Meghd2cx/EECS149-AdjustableCamber/README.md

# EECS149-AdjustableCamber
EECS149 Spring 149 Project
