Meghd2cx/EECS149-AdjustableCamber/State Machine.pdf

STRAIGHT

ENTRY /
EXIT

APEX

### Inputs: Enable : pure, StrPos ∈ ℝ Outputs: CamberDes ∈ ℝ Constants: StrOffset, StrError, StrSteady ∈ ℝ

## Notes:

- Enable → button input to enable active camber control - StrPos → Steering Linear Potentiometer Voltage [V] - CamberDes → desired camber angle - StrOffset → voltage at neutral/center steering position - StrError → max voltage error for neutral/center steering position - StrSteady → max allowed change in steering for constant steering

### Left Front Corner - Steering left → positive steering lin pot voltage, inside tire - Steering right → negative steering lin pot voltage, outside tire

| StrPos - StrOffset| > StrError && StrPos > StrOffset / CamberDes:= 1º
| StrPos - StrOffset| > StrError && StrPos < StrOffset / CamberDes = -1º

| StrPos - StrOffset| < StrError / CamberDes:= -0.5º

|d/dt (StrPos) | < StrSteady && StrPos > StrOffset /
CamberDes:= 2º
|d/dt (StrPos) | < StrSteady && StrPos < StrOffset /
CamberDes = -2º

sign(d/dt(StrPos)) ≠ sign(StrPos - StrOffset) && StrPos > StrOffset / CamberDes:= 1º
sign(d/dt(StrPos)) ≠ sign(StrPos - StrOffset) && StrPos < StrOffset /
CamberDes = -1º
Enable / | OFF
CamberDes := -0.5º | not(Enable) / CamberDes := -0.5º

not(Enable) /
CamberDes := -0.5º | not(Enable) /
| CamberDes := -0.5º

not(Enable) /
CamberDes := -0.5º
