Meghd2cx/EECS149-AdjustableCamber/BOM.xlsx

Subsystem | Required Parts | Listing Name | Quantity | Cost | Source Links
Mechanical | 3D-Printing Filament for Upright | Markforged Onyx Filament | 211 cc | - | personal printer material
 | Tubes for Upper Control-Arms | Easy-to-Weld 4130 Alloy Steel Round Tube, 0.035" Wall Thickness, 1/2" OD | 3 ft | - | borrowed from Berkeley Formula Racing
 | Tubes for Lower Control-Arms | Easy-to-Weld 4130 Alloy Steel Round Tubes | 6 ft | - | borrowed from Berkeley Formula Racing
 | Tubes for Camber Movement Arm | Easy-to-Weld 4130 Alloy Steel Round Tube, 0.035" Wall Thickness, 1/2" OD | 1 ft | - | borrowed from Berkeley Formula Racing
 | Tubes for Steering Tierod | Easy-to-Weld 4130 Alloy Steel Round Tube, 0.035" Wall Thickness, 1/2" OD | 1 ft | - | borrowed from Berkeley Formula Racing
 | Tube for Pushrod |  | 1 ft | - | borrowed from Berkeley Formula Racing
 | Welding Filler | Steel Welding Filler | ~2 rods | - | borrowed from Berkeley Formula Racing
 | Spring & Shock |  | 1 | - | borrowed from Berkeley Formula Racing
 | Upper Outer Ball Joint |  | 1 | - | borrowed from Berkeley Formula Racing
 | Upper Inner Ball Joint |  | 1 | - | borrowed from Berkeley Formula Racing
 | Lower Outer Ball Joint |  | 1 | - | borrowed from Berkeley Formula Racing
 | Lower Inner Ball Joint |  | 2 | - | borrowed from Berkeley Formula Racing
 | Steering Outer Ball Joint |  | 1 | - | borrowed from Berkeley Formula Racing
 | Motor Linkage stock |  | 1 | - | borrowed from Berkeley Formula Racing
 | Pushbar Linkage Stock |  | 1 | - | borrowed from Berkeley Formula Racing
 | AN3 Bolts |  | 14 | - | borrowed from Berkeley Formula Racing
 | AN3 washers |  | 28 | - | borrowed from Berkeley Formula Racing
 | AN3 KNuts |  | 4 | - | borrowed from Berkeley Formula Racing
 | Rod Ends |  | 8 | - | borrowed from Berkeley Formula Racing
Electrical | Microcontroller | ESP32-WROOM32UE | 1 | $16.99 | Amazon.com: ESP-WROOM-32 ESP32 ESP-32S Development Board 2.4GHz Dual-Mode WiFi + Bluetooth Dual Cores Microcontroller Processor Integrated with Antenna RF AMP Filter AP STA Compatible with Arduino IDE (3PCS) : Electronics (https://www.amazon.com/ESP-WROOM-32-Development-Microcontroller-Integrated-Compatible/dp/B08D5ZD528)
 | CAN Controller | Comimark 5Pcs CAN Bus Module Transceiver TJA1050 Controller Board | 1 | $8.99 | Amazon.com: Comimark 5Pcs CAN Bus Module Transceiver TJA1050 Controller Schnittstelle Board for Arduino : Electronics (https://www.amazon.com/Comimark-Transceiver-TJA1050-Controller-Schnittstelle/dp/B07W4VZ2F2)
 | Motor | 131:1 Metal Gearmotor 37Dx73L mm 12V with 64 CPR Encoder (Helical Pinion) | 1 | $51.95 | https://www.pololu.com/product/4756
 | Motor Driver | Pololu Dual VNH5019 Motor Driver Shield for Arduino | 1 | $59.95 | https://www.pololu.com/product/2507
 | 12v Vehicle Battery | Shorai LFX19A4-BS12 | 1 | - | borrowed from Berkeley Formula Racing
 | Steering Angle Potentiometer | Corsa Technic SEN-LHP | 1 | - | borrowed from Berkeley Formula Racing
 | Inertial Measurement Unit | Izze-Racing 6-DOF CAN Inertial Measurement Unit | 1 | - | borrowed from Berkeley Formula Racing
 | Total |  |  | $137.88
