Meghd2cx/EECS149-AdjustableCamber/CAD/24-SU-14-000.SLDASM

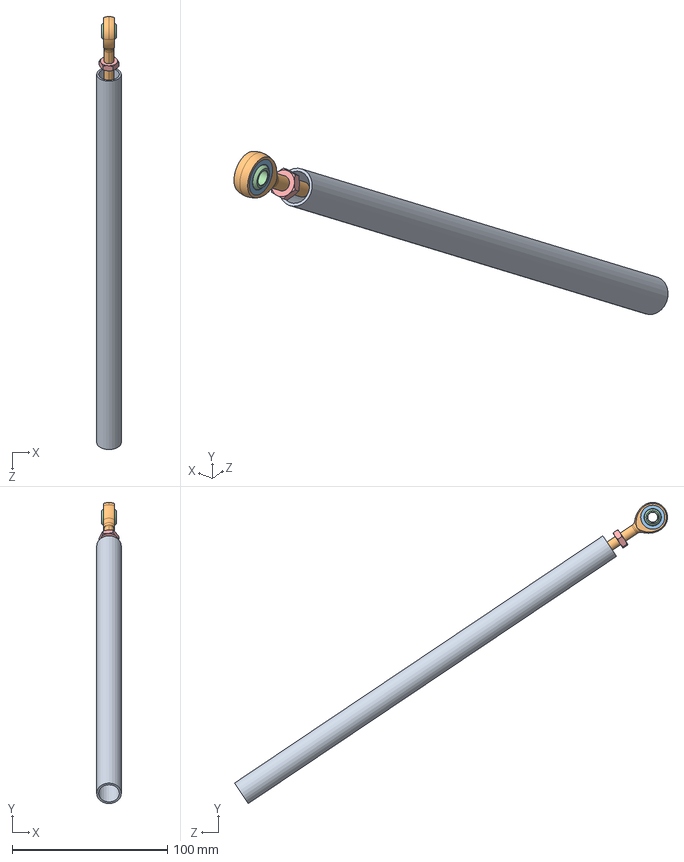
[picture p7: CAD file, 2024-11-09]
CAD/24-SU-14-000.SLDASM
15.9 x 193.9 x 278.8 mm
24-SU-14-001
MM-4T Rod End Body
MM-4T Bearing Bore
MM-4T Ball Bearing
AN4_JamNut
