Meghd2cx/EECS149-AdjustableCamber/CAD/MM-4T.SLDASM

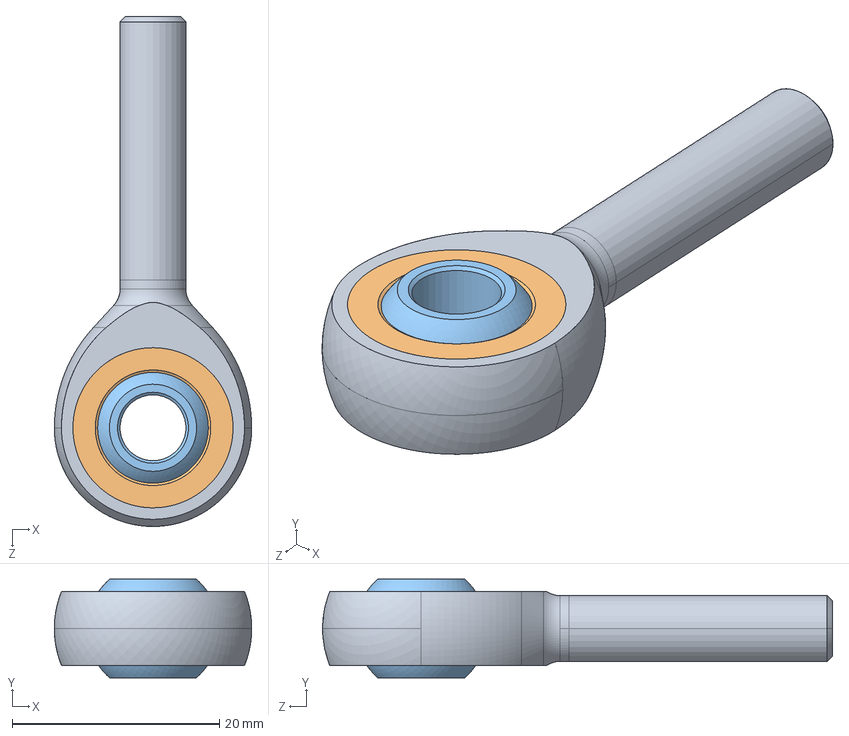
[picture p8: CAD file, 2024-11-09]
CAD/MM-4T.SLDASM
19.1 x 9.53 x 49.2 mm
MM-4T Rod End Body
MM-4T Bearing Bore
MM-4T Ball Bearing
