Meghd2cx/EECS149-AdjustableCamber/CAD/23-SU-15-000.SLDASM

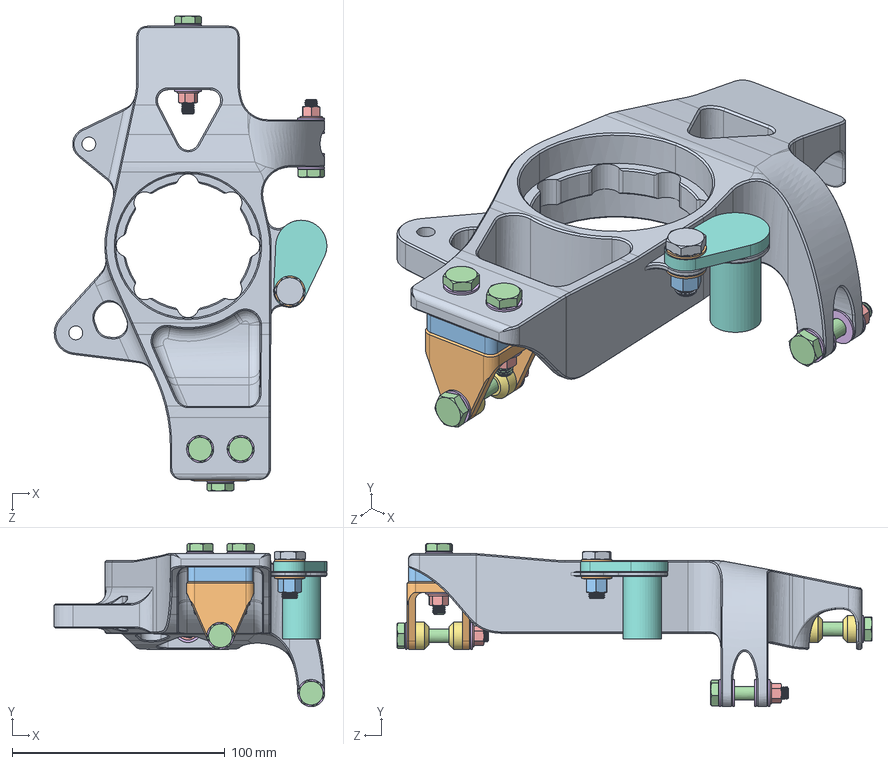
[picture p9: CAD file, 2024-11-09]
CAD/23-SU-15-000.SLDASM
128.0 x 76.7 x 223.0 mm
23-SU-15-001
23-SU-15-002
23-SU-15-006
AN4_Bolt x 5
AN4_KNut x 5
AN4_Washer x 12
23-SU-35-005 x 4
20-SU-15-005
AN5_Bolt
AN5_Washer x 2
AN5_KNut
