Meghd2cx/EECS149-AdjustableCamber/CAD/ASM-4T.SLDASM

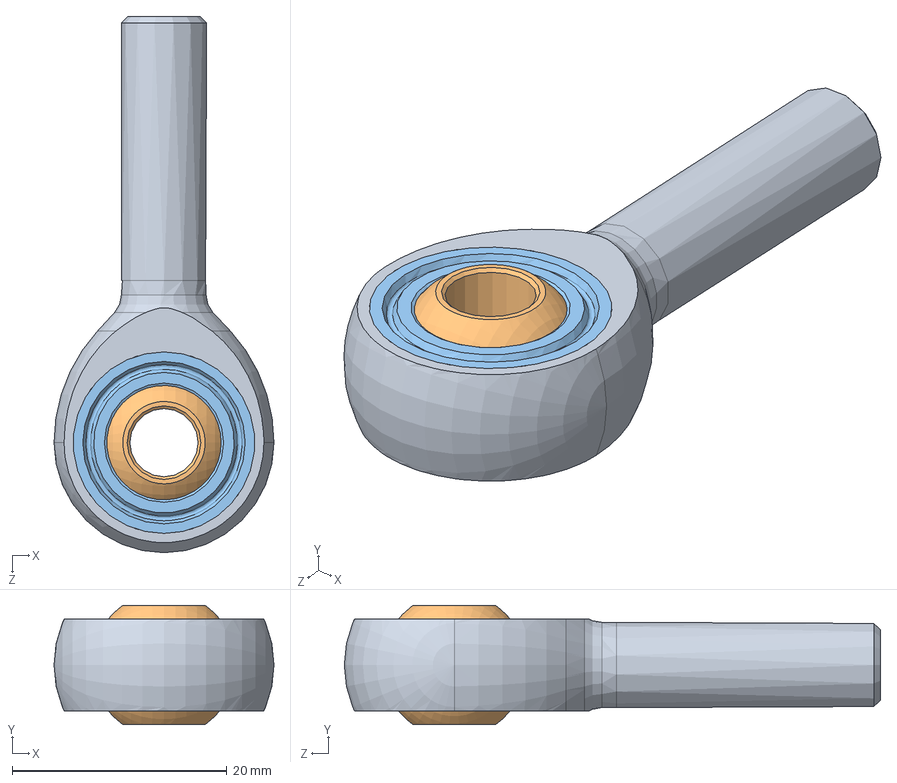
[picture p10: CAD file, 2024-11-09]
CAD/ASM-4T.SLDASM
20.5 x 11.1 x 49.9 mm
ASM-4T Rod End Body
ASM-4T Ball Bearing
ASM-4T Staked Bearing
