Meghd2cx/EECS149-AdjustableCamber/CAD/24-SU-22-000.SLDASM

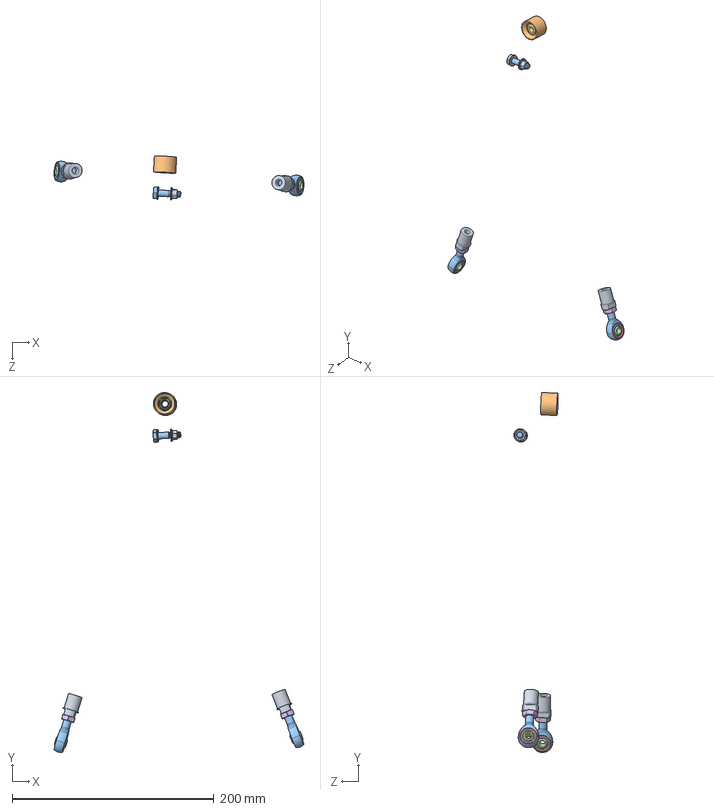
[picture p11: CAD file, 2024-11-09]
CAD/24-SU-22-000.SLDASM
247.6 x 356.7 x 44.0 mm
24-SU-20-003
24-SU-25-004 x 2
ASM-4T Rod End Body x 2
ASM-4T Ball Bearing x 2
ASM-4T Staked Bearing x 2
AN5_JamNut x 2
MIB-4T
99142A370_BLACK-FINISH STEEL INTERNAL RETAINING RING
AN4_KNut
AN4_Washer x 2
AN4_Bolt
