Meghd2cx/EECS149-AdjustableCamber/CAD/ASM-4T Ball Bearing.SLDPRT

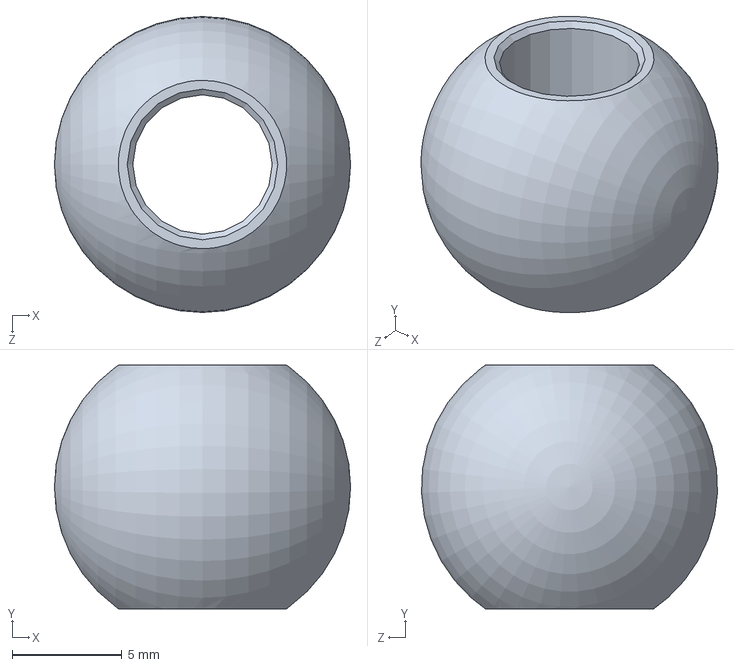
[picture p12: CAD file, 2024-11-09]
CAD/ASM-4T Ball Bearing.SLDPRT
13.5 x 11.1 x 13.5 mm
