Meghd2cx/EECS149-AdjustableCamber/CAD/ASM-4T Staked Bearing.SLDPRT

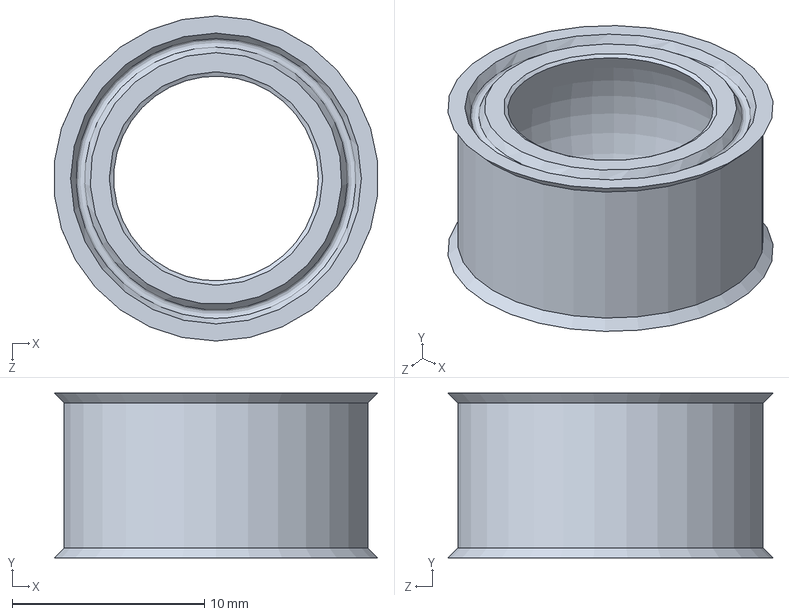
[picture p13: CAD file, 2024-11-09]
CAD/ASM-4T Staked Bearing.SLDPRT
16.8 x 8.56 x 16.9 mm
