Meghd2cx/EECS149-AdjustableCamber/CAD/24-SU-21-000.SLDASM

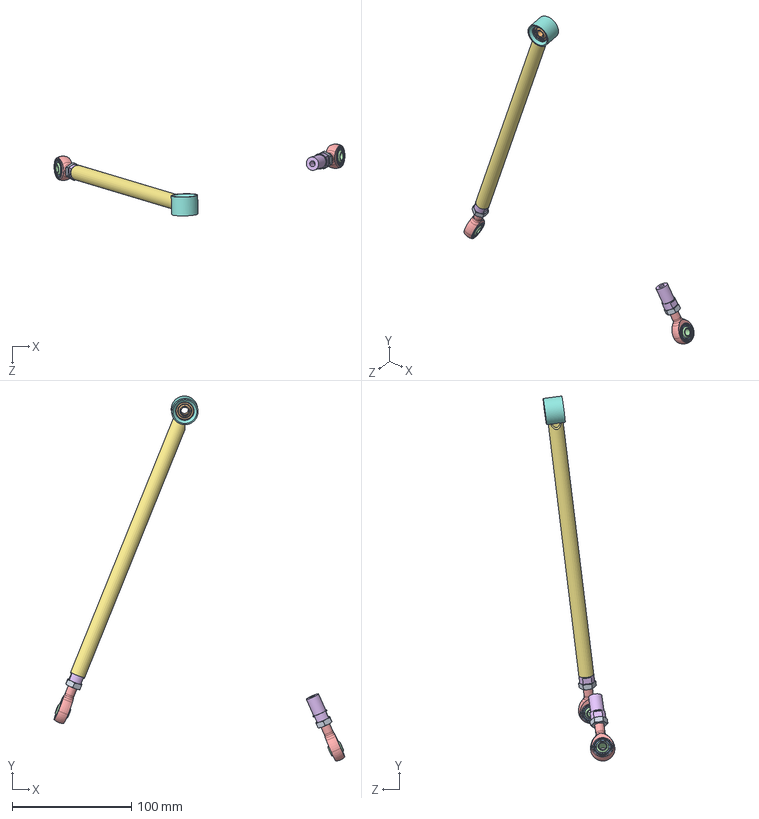
[picture p15: CAD file, 2024-11-09]
CAD/24-SU-21-000.SLDASM
244.2 x 306.5 x 60.3 mm
24-SU-20-003
24-SU-21-001
24-SU-25-001 x 2
ASM-4T Rod End Body x 2
ASM-4T Ball Bearing x 2
ASM-4T Staked Bearing x 2
MIB-4T
AN5_JamNut x 2
