Meghd2cx/EECS149-AdjustableCamber/CAD/24-SU-50-000.SLDASM

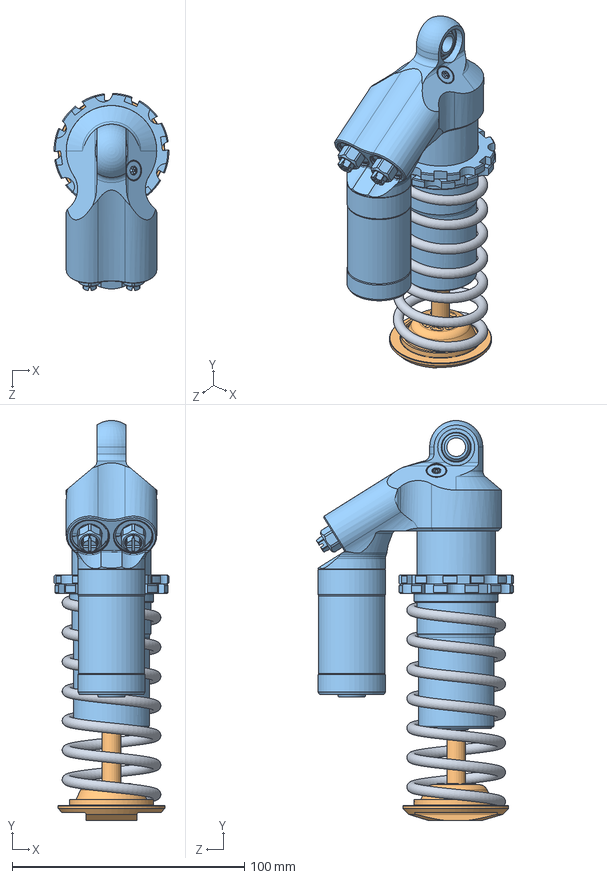
[picture p16: CAD file, 2024-11-09]
CAD/24-SU-50-000.SLDASM
49.5 x 172.3 x 85.0 mm
24-SU-50-001
24-SU-50-002
24-SU-50-003
