Meghd2cx/EECS149-AdjustableCamber/CAD/ASM-4T Rod End Body.SLDPRT

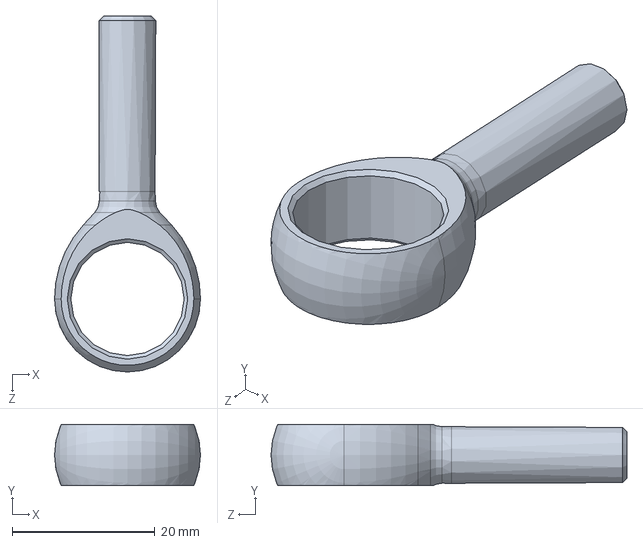
[picture p17: CAD file, 2024-11-09]
CAD/ASM-4T Rod End Body.SLDPRT
20.5 x 8.56 x 49.9 mm
