Meghd2cx/EECS149-AdjustableCamber/CAD/AN4_JamNut.SLDPRT

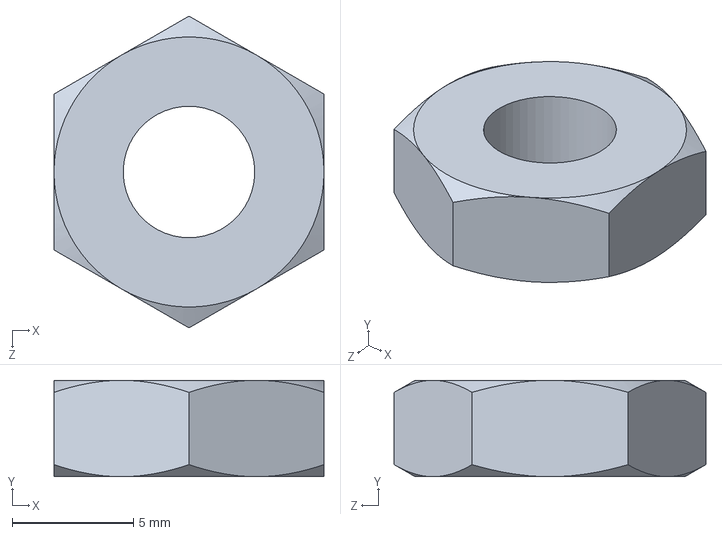
[picture p18: CAD file, 2024-11-09]
CAD/AN4_JamNut.SLDPRT
11.1 x 3.97 x 12.8 mm
