Meghd2cx/EECS149-AdjustableCamber/CAD/MM-4T Rod End Body.SLDPRT

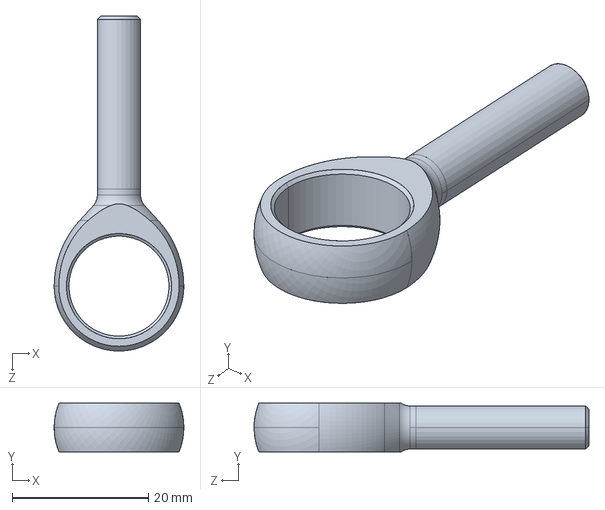
[picture p19: CAD file, 2024-11-09]
CAD/MM-4T Rod End Body.SLDPRT
19.1 x 7.14 x 49.2 mm
