Meghd2cx/EECS149-AdjustableCamber/CAD/AN5_JamNut.SLDPRT

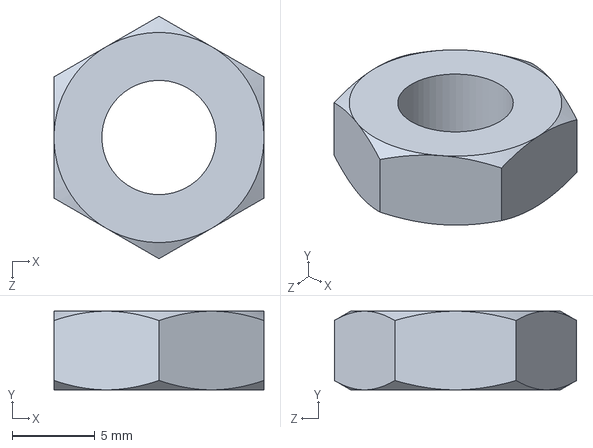
[picture p20: CAD file, 2024-11-09]
CAD/AN5_JamNut.SLDPRT
12.7 x 4.76 x 14.7 mm
