Meghd2cx/EECS149-AdjustableCamber/CAD/24-SU-40-005.SLDPRT

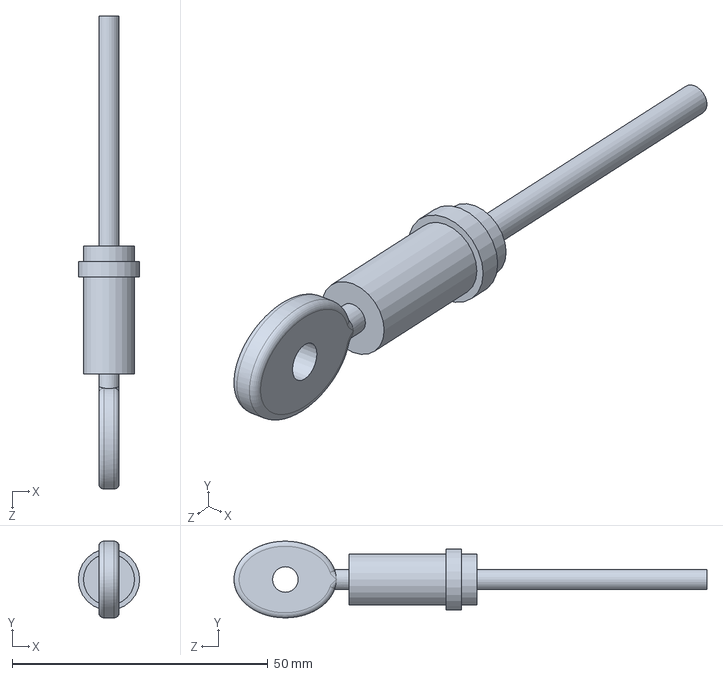
[picture p21: CAD file, 2024-11-09]
CAD/24-SU-40-005.SLDPRT
12.0 x 15.0 x 92.5 mm
