Meghd2cx/EECS149-AdjustableCamber/CAD/23-SU-35-006.SLDPRT

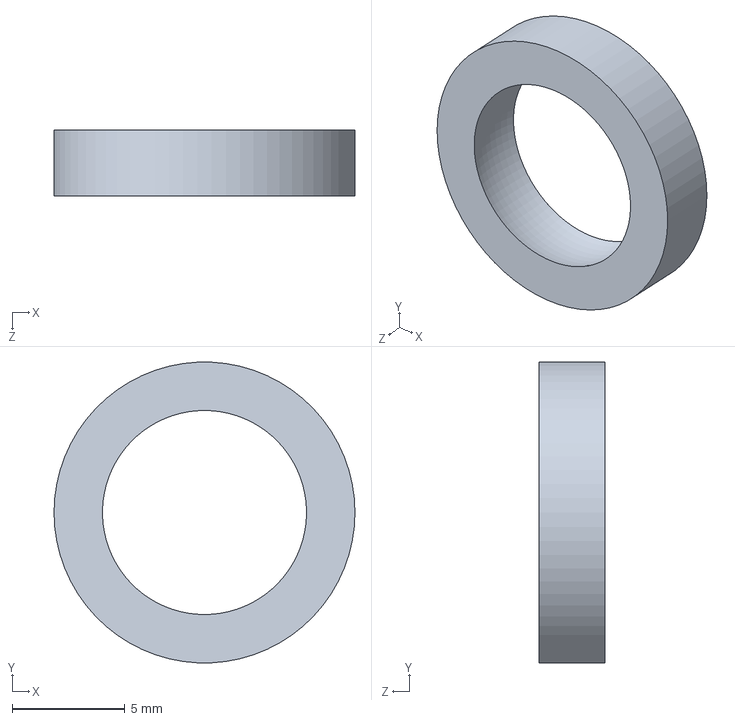
[picture p22: CAD file, 2024-11-09]
CAD/23-SU-35-006.SLDPRT
13.4 x 13.4 x 2.92 mm
