Meghd2cx/EECS149-AdjustableCamber/CAD/MM-4T Ball Bearing.SLDPRT

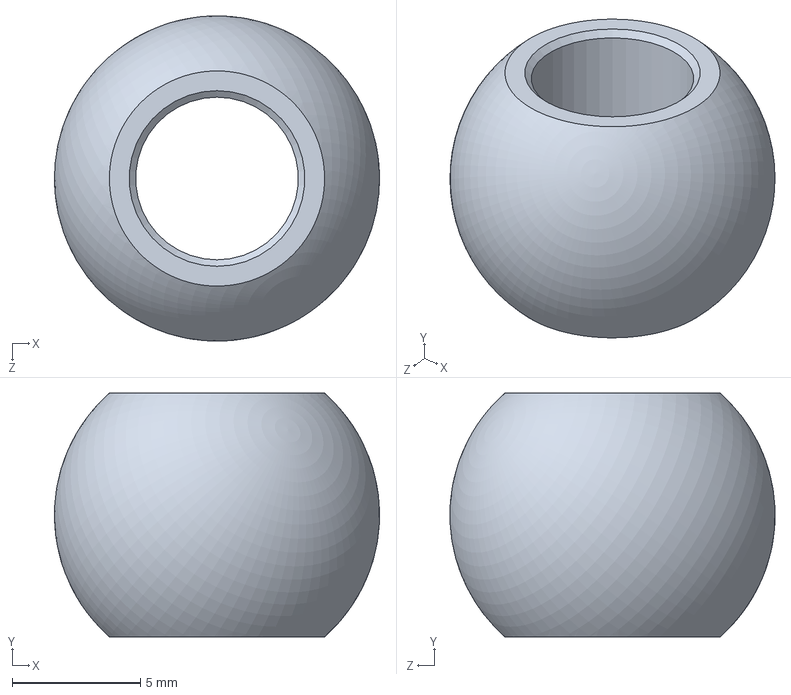
[picture p23: CAD file, 2024-11-09]
CAD/MM-4T Ball Bearing.SLDPRT
12.7 x 9.53 x 12.7 mm
