Meghd2cx/EECS149-AdjustableCamber/CAD/AN5_KNut.SLDPRT

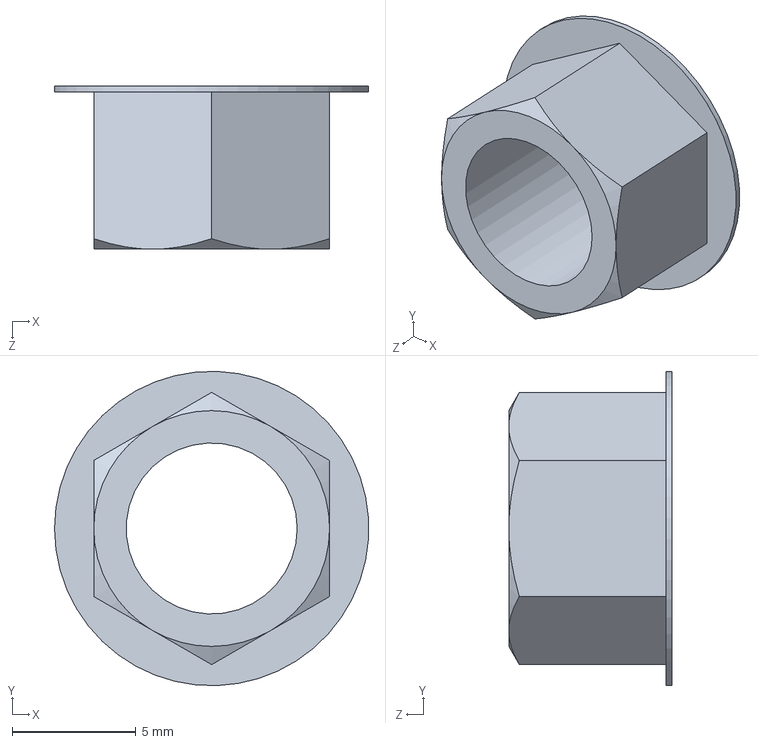
[picture p24: CAD file, 2024-11-09]
CAD/AN5_KNut.SLDPRT
12.7 x 12.7 x 6.60 mm
