Meghd2cx/EECS149-AdjustableCamber/CAD/24-SU-21-001.SLDPRT

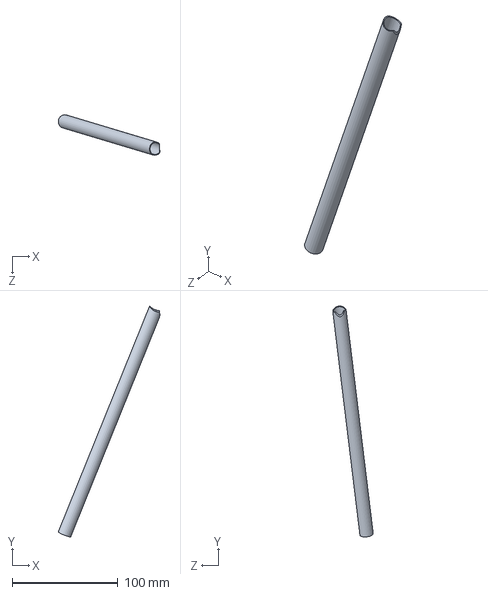
[picture p25: CAD file, 2024-11-09]
CAD/24-SU-21-001.SLDPRT
96.0 x 218.4 x 38.3 mm
