Meghd2cx/EECS149-AdjustableCamber/CAD/24-SU-35-005.SLDPRT

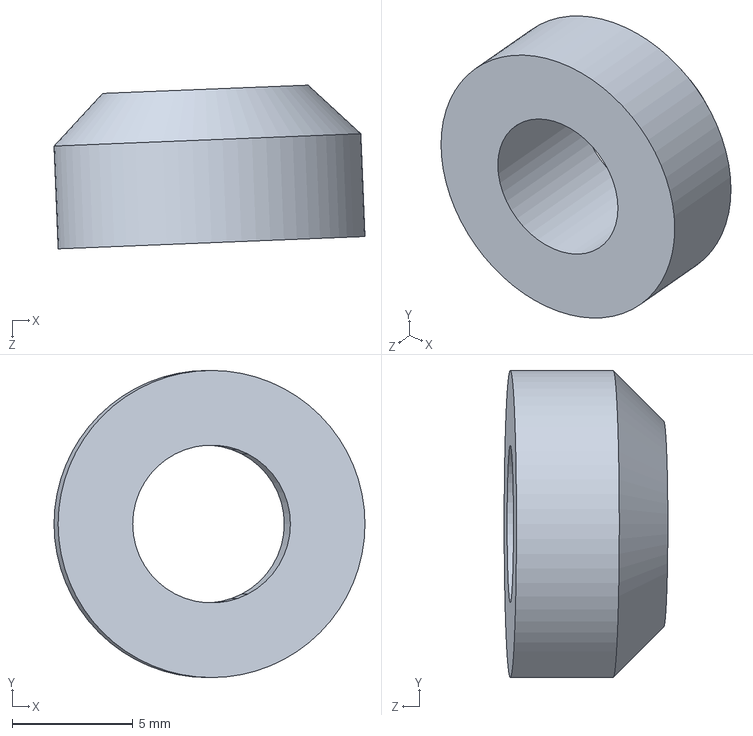
[picture p26: CAD file, 2024-11-09]
CAD/24-SU-35-005.SLDPRT
12.9 x 12.7 x 6.77 mm
