Meghd2cx/EECS149-AdjustableCamber/CAD/24-SU-50-003.SLDPRT

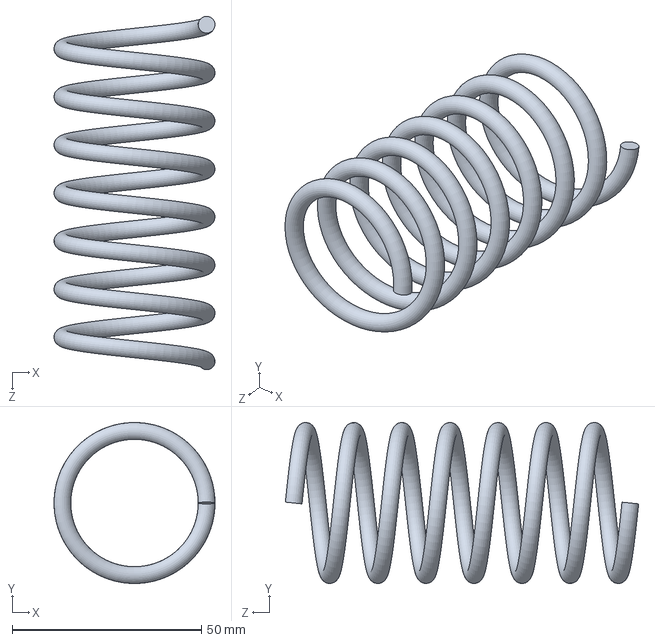
[picture p27: CAD file, 2024-11-09]
CAD/24-SU-50-003.SLDPRT
42.5 x 42.5 x 93.3 mm
