Meghd2cx/EECS149-AdjustableCamber/CAD/24-SU-15-001.SLDPRT

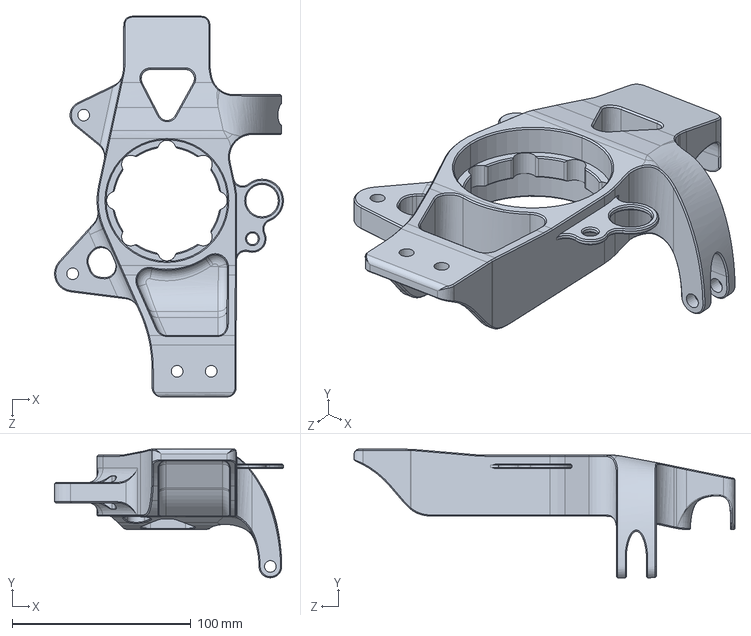
[picture p28: CAD file, 2024-11-09]
CAD/24-SU-15-001.SLDPRT
128.0 x 71.9 x 212.9 mm
