Meghd2cx/EECS149-AdjustableCamber/CAD/24-SU-15-006.SLDPRT

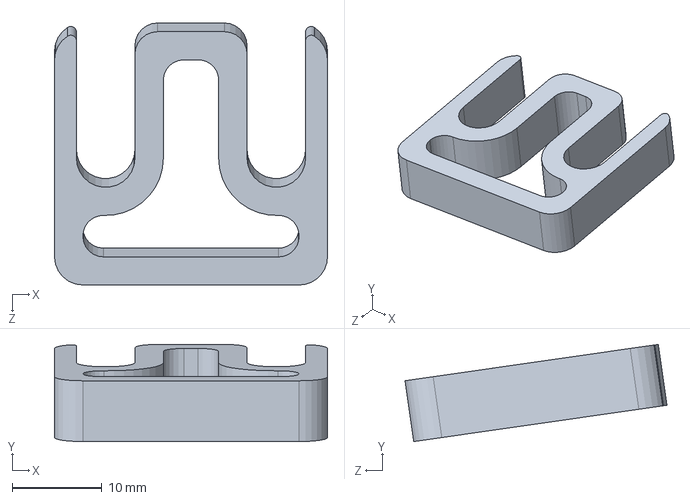
[picture p29: CAD file, 2024-11-09]
CAD/24-SU-15-006.SLDPRT
30.5 x 10.8 x 29.3 mm
