Meghd2cx/EECS149-AdjustableCamber/CAD/UprightBearing.SLDPRT

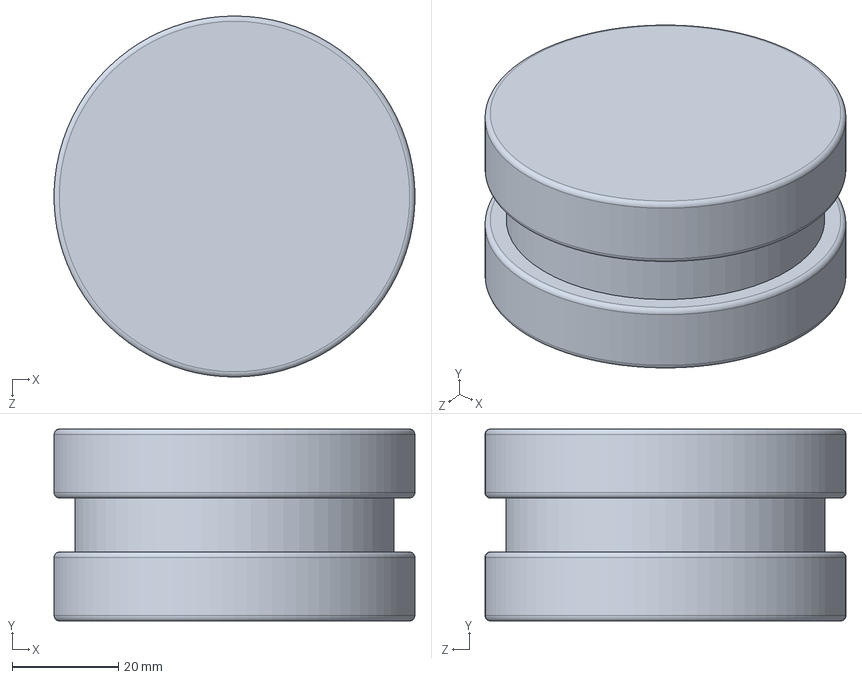
[picture p30: CAD file, 2024-11-09]
CAD/UprightBearing.SLDPRT
68.0 x 36.2 x 68.0 mm
