Meghd2cx/EECS149-AdjustableCamber/CAD/20-BR-01-004.SLDPRT

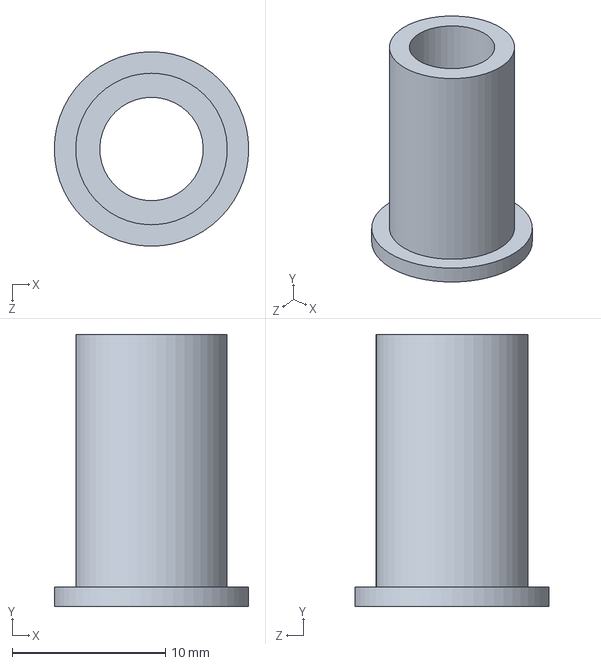
[picture p31: CAD file, 2024-11-09]
CAD/20-BR-01-004.SLDPRT
12.7 x 17.8 x 12.7 mm
