Meghd2cx/EECS149-AdjustableCamber/CAD/24-SU-40-013.SLDPRT

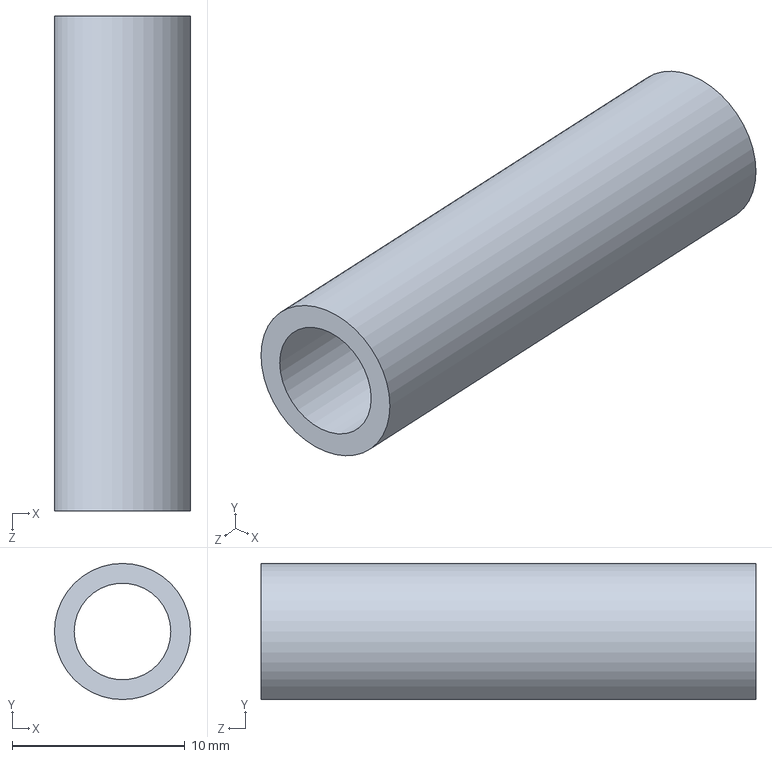
[picture p32: CAD file, 2024-11-09]
CAD/24-SU-40-013.SLDPRT
7.87 x 7.87 x 28.6 mm
