Meghd2cx/EECS149-AdjustableCamber/CAD/20-SU-15-005.SLDPRT

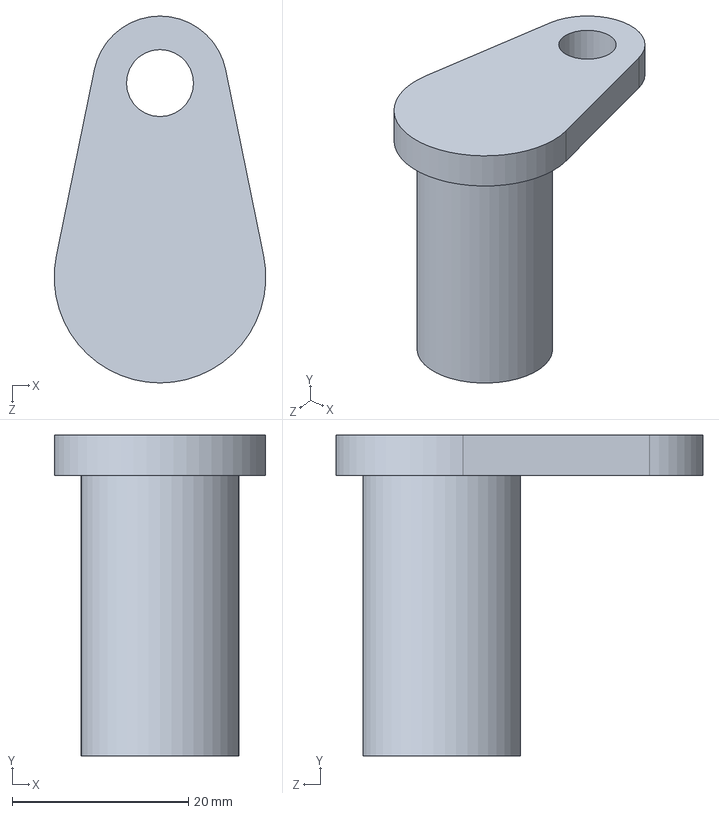
[picture p33: CAD file, 2024-11-09]
CAD/20-SU-15-005.SLDPRT
24.0 x 36.4 x 41.6 mm
