Meghd2cx/EECS149-AdjustableCamber/CAD/24-SU-25-004.SLDPRT

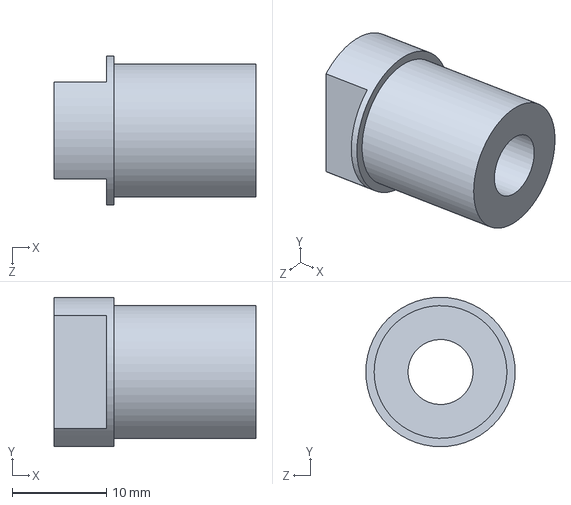
[picture p34: CAD file, 2024-11-09]
CAD/24-SU-25-004.SLDPRT
21.5 x 15.9 x 15.9 mm
