Meghd2cx/EECS149-AdjustableCamber/CAD/24-SU-40-002.SLDPRT

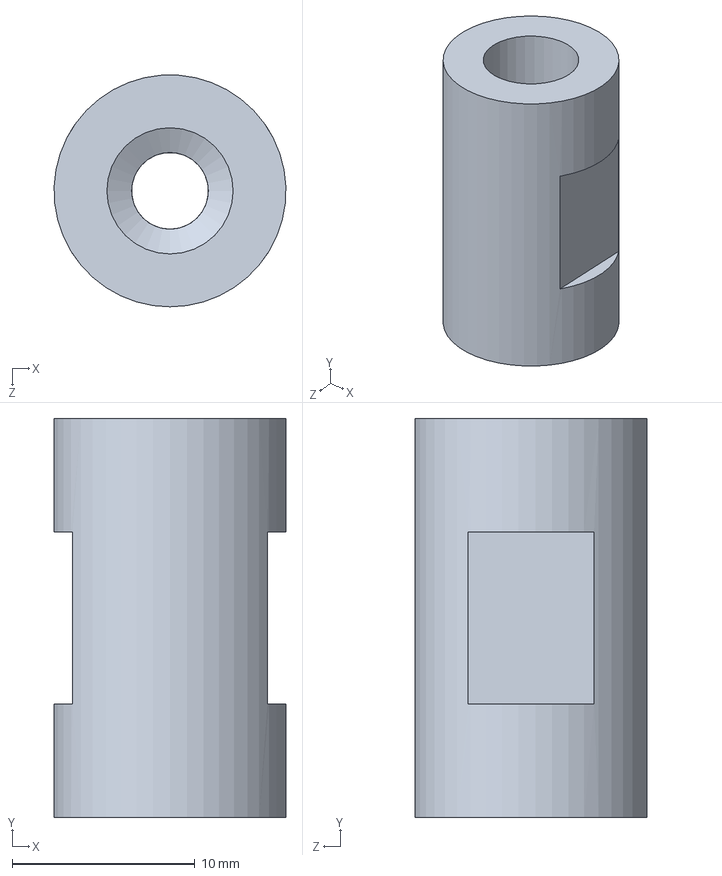
[picture p35: CAD file, 2024-11-09]
CAD/24-SU-40-002.SLDPRT
12.7 x 21.8 x 12.7 mm
