Meghd2cx/EECS149-AdjustableCamber/CAD/24-SU-50-001.SLDPRT

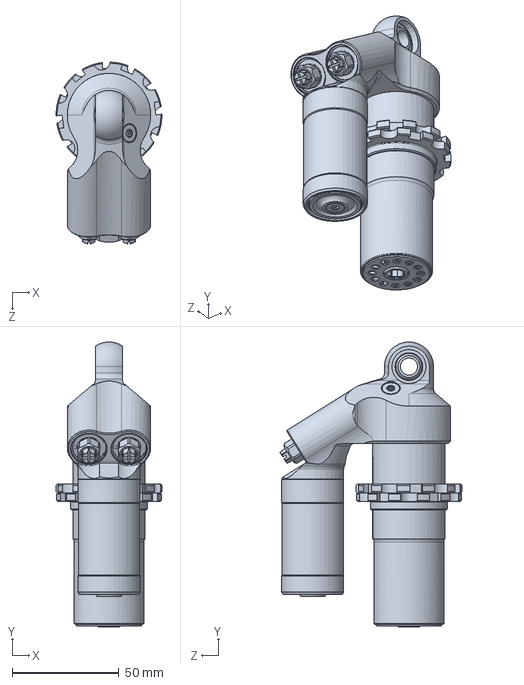
[picture p36: CAD file, 2024-11-09]
CAD/24-SU-50-001.SLDPRT
49.5 x 133.3 x 85.0 mm
