Meghd2cx/EECS149-AdjustableCamber/CAD/24-SU-14-001.SLDPRT

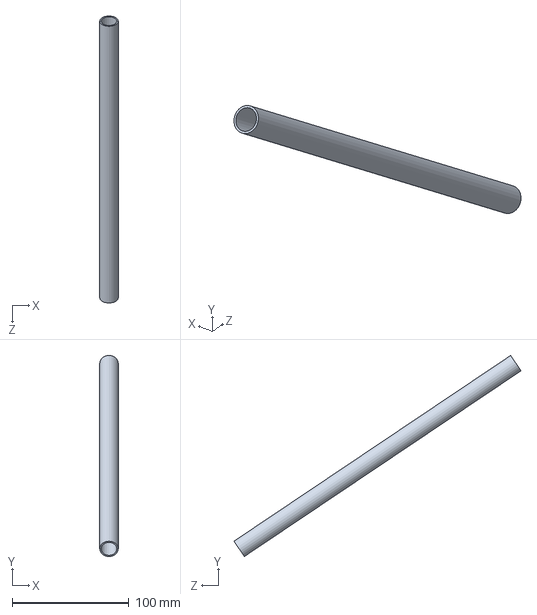
[picture p37: CAD file, 2024-11-09]
CAD/24-SU-14-001.SLDPRT
15.9 x 172.4 x 246.0 mm
