Meghd2cx/EECS149-AdjustableCamber/CAD/24-SU-25-001.SLDPRT

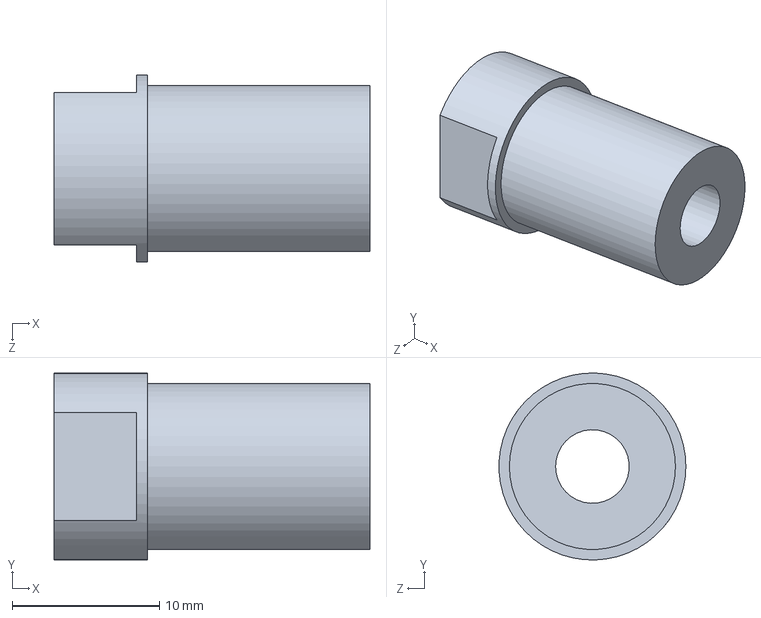
[picture p38: CAD file, 2024-11-09]
CAD/24-SU-25-001.SLDPRT
21.5 x 12.7 x 12.7 mm
