Meghd2cx/EECS149-AdjustableCamber/CAD/24-SU-50-002.SLDPRT

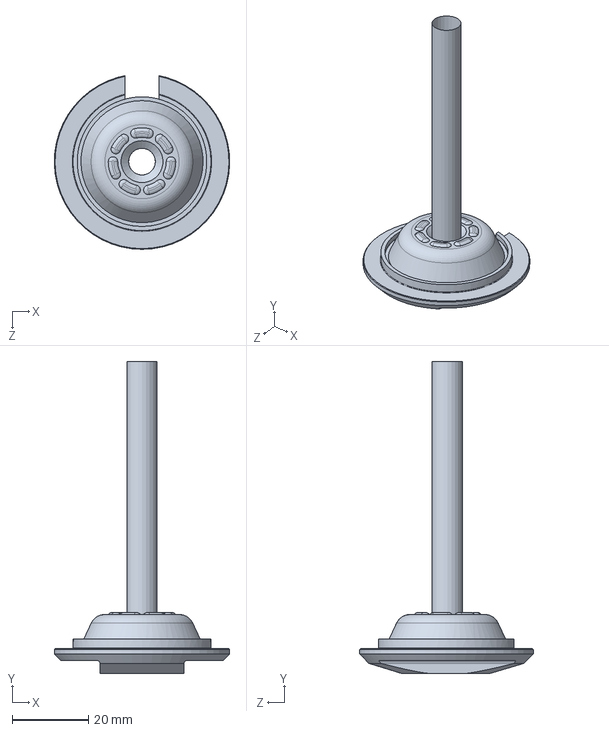
[picture p39: CAD file, 2024-11-09]
CAD/24-SU-50-002.SLDPRT
46.0 x 81.8 x 45.6 mm
