Meghd2cx/EECS149-AdjustableCamber/CAD/24-SU-20-003.SLDPRT

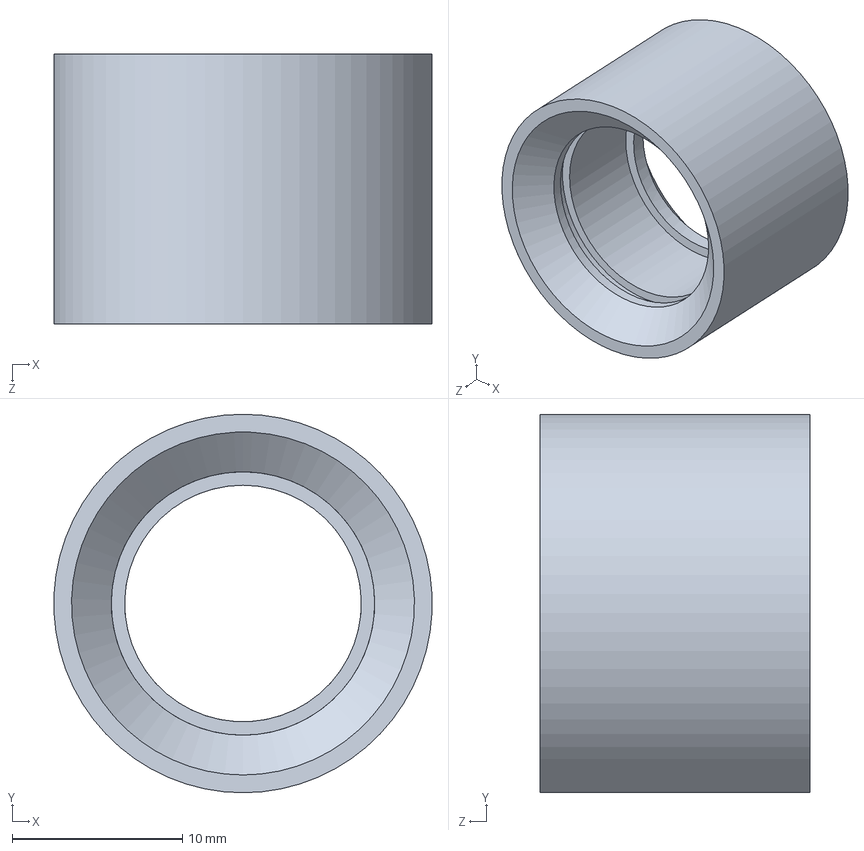
[picture p40: CAD file, 2024-11-09]
CAD/24-SU-20-003.SLDPRT
22.2 x 22.2 x 15.9 mm
