Meghd2cx/EECS149-AdjustableCamber/CAD/24-SU-40-012.SLDPRT

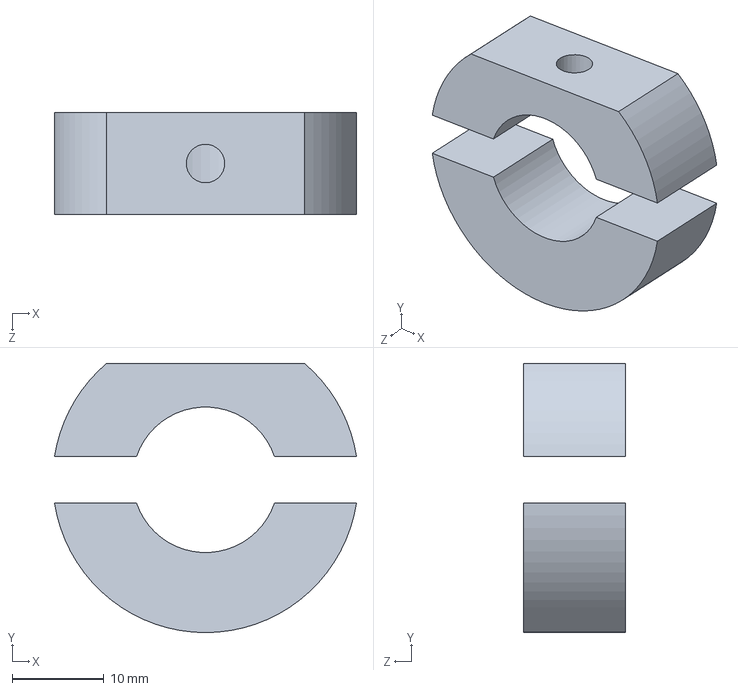
[picture p41: CAD file, 2024-11-09]
CAD/24-SU-40-012.SLDPRT
32.9 x 29.4 x 11.1 mm
