Meghd2cx/EECS149-AdjustableCamber/CAD/MIB-4T.SLDPRT

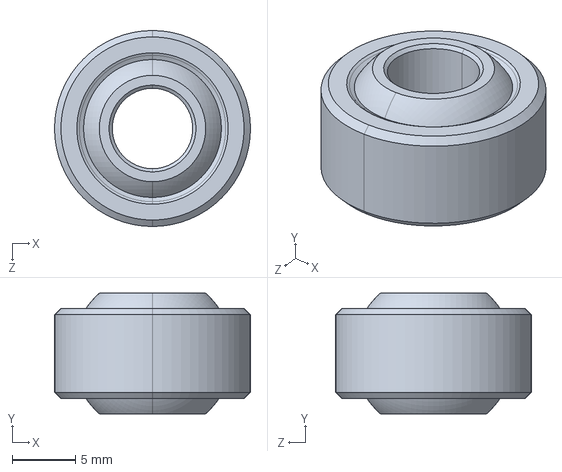
[picture p42: CAD file, 2024-11-09]
CAD/MIB-4T.SLDPRT
15.5 x 9.53 x 15.5 mm
