Meghd2cx/EECS149-AdjustableCamber/CAD/24-SU-21-002.SLDPRT

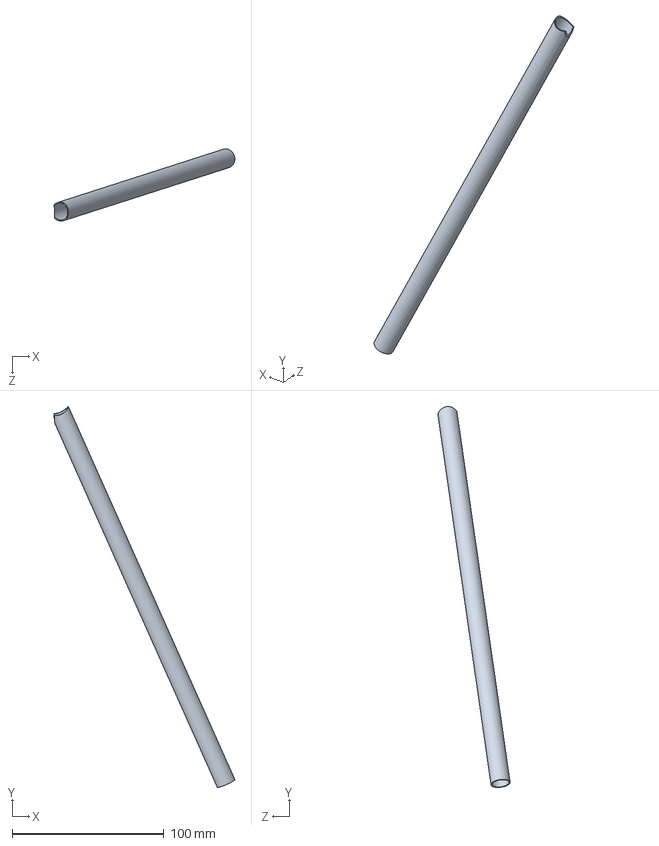
[picture p43: CAD file, 2024-11-09]
CAD/24-SU-21-002.SLDPRT
119.1 x 251.1 x 47.6 mm
