Meghd2cx/EECS149-AdjustableCamber/CAD/24-SU-25-005.SLDPRT

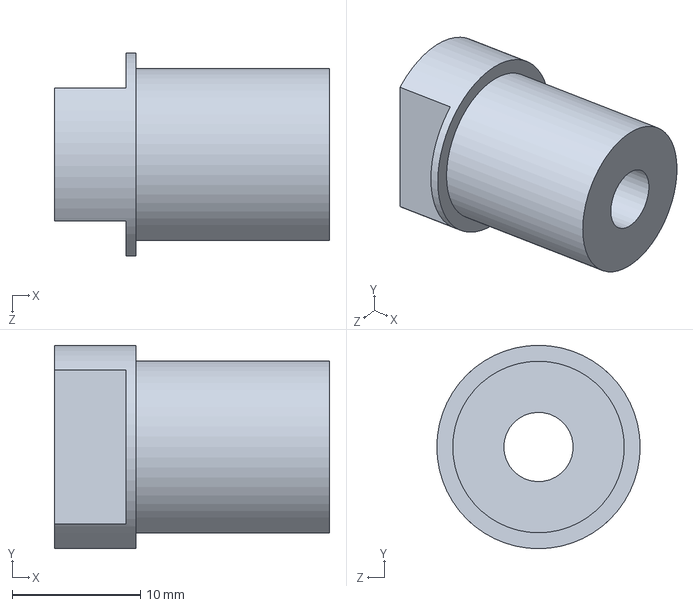
[picture p44: CAD file, 2024-11-09]
CAD/24-SU-25-005.SLDPRT
21.5 x 15.9 x 15.9 mm
