Meghd2cx/EECS149-AdjustableCamber/CAD/24-SU-70-002.SLDPRT

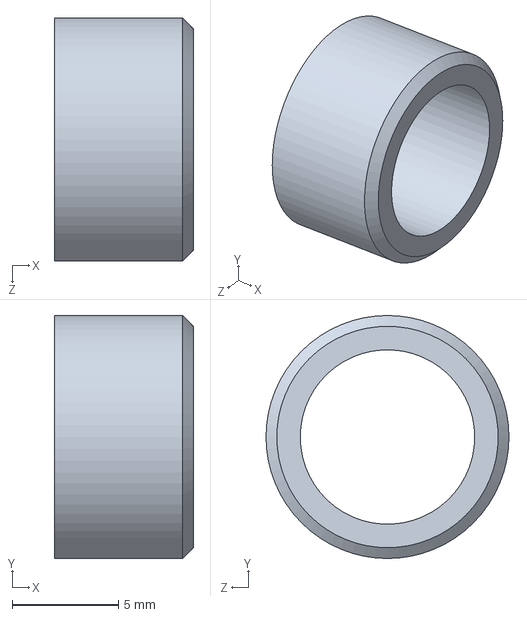
[picture p45: CAD file, 2024-11-09]
CAD/24-SU-70-002.SLDPRT
6.54 x 11.4 x 11.4 mm
