Meghd2cx/EECS149-AdjustableCamber/CAD/24-SU-40-004.SLDPRT

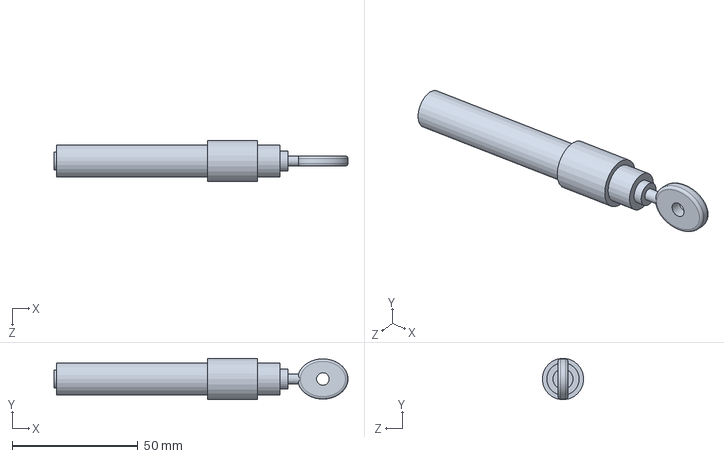
[picture p46: CAD file, 2024-11-09]
CAD/24-SU-40-004.SLDPRT
117.0 x 16.5 x 16.5 mm
