Meghd2cx/EECS149-AdjustableCamber/CAD/AN4_KNut.SLDPRT

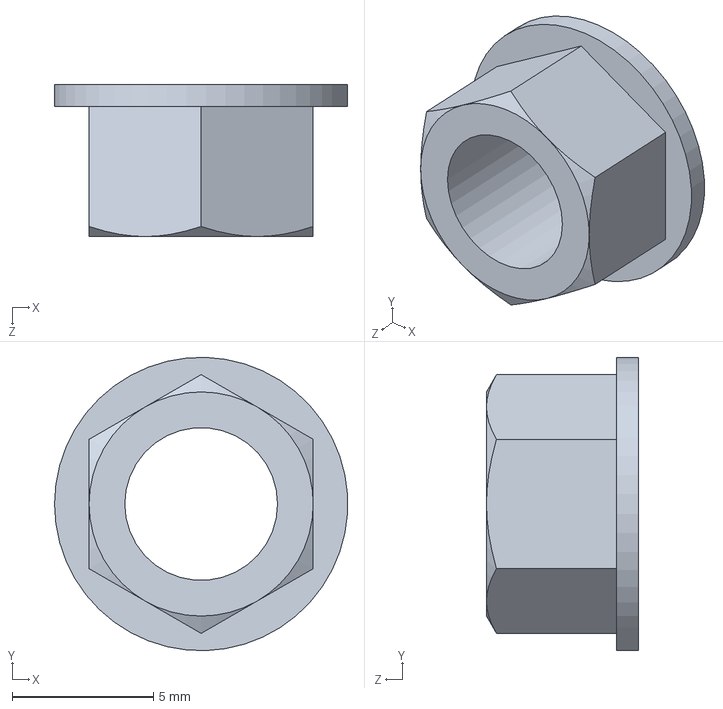
[picture p47: CAD file, 2024-11-09]
CAD/AN4_KNut.SLDPRT
10.4 x 10.4 x 5.38 mm
