Meghd2cx/EECS149-AdjustableCamber/CAD/24-SU-35-000.SLDASM

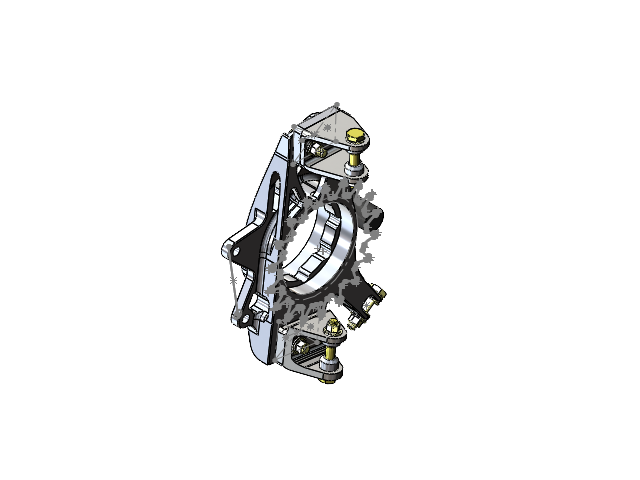
[picture p48: CAD file, 2024-11-09]
CAD/24-SU-35-000.SLDASM
24-SU-35-005 x 4
24-SU-35-003
24-SU-35-002
24-SU-35-004
24-SU-35-001
AN4_Bolt x 8
AN4_KNut x 8
AN4_Washer x 18
22-SU-15-005
