Meghd2cx/EECS149-AdjustableCamber/CAD/24-SU-40-006.SLDASM

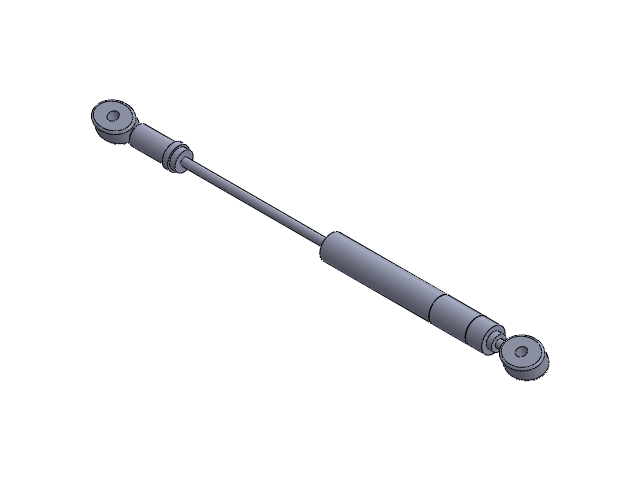
[picture p49: CAD file, 2024-11-09]
CAD/24-SU-40-006.SLDASM
24-SU-40-004
24-SU-40-005
