Meghd2cx/EECS149-AdjustableCamber/(list of files, cad)

Other CAD files:
CAD/24-SU-15-002.SLDPRT
CAD/24-SU-22-003.SLDPRT
CAD/23-SU-15-003.SLDPRT
CAD/24-SU-22-005.SLDPRT
CAD/24-SU-00-001.SLDPRT
CAD/24-SU-22-002.SLDPRT
CAD/24-SU-14-002.SLDPRT
CAD/MM-4T Bearing Bore.SLDPRT
CAD/24-SU-22-004.SLDPRT
CAD/MirrorrMM-4T Ball Bearing.SLDPRT
CAD/MirrorCaliperRearPart _1.SLDPRT
CAD/24-SU-22-001.SLDPRT
CAD/91290A198_Alloy Steel Socket Head Screw.SLDPRT
CAD/91290A231_Alloy Steel Socket Head Screw.SLDPRT
CAD/99142A370_BLACK-FINISH STEEL INTERNAL RETAINING RING.SLDPRT
CAD/AN4_Bolt.SLDPRT
CAD/AN4_Washer.SLDPRT
CAD/AN5_Bolt.SLDPRT
CAD/AN5_Washer.SLDPRT
