Meghd2cx/EECS149-AdjustableCamber/(commit log)

2024-11-09 CAD initial commit
    [20-BR-01-004.SLDPRT, 20-SU-15-005.SLDPRT, 23-SU-15-000.SLDASM, 23-SU-15-003.SLDPRT, 23-SU-35-006.SLDPRT, 24-SU-00-001.SLDPRT, 24-SU-14-000.SLDASM, 24-SU-14-001.SLDPRT]
2024-11-09 CAD Assembly files
2024-11-09 BoM initial commit
    [BOM.xlsx]
2024-12-09 Basic state machine using steering input only
2024-12-09 Initial implementation with steering input only. Motor control constants need tuning.
2024-12-09 Photos & Video of Suspension Assembly
2024-12-17 checking diff, added working imu
2024-12-17 IMU working
